HandHeldLegend/UniSNES/PCB/USB-C Wire Diagram External.png

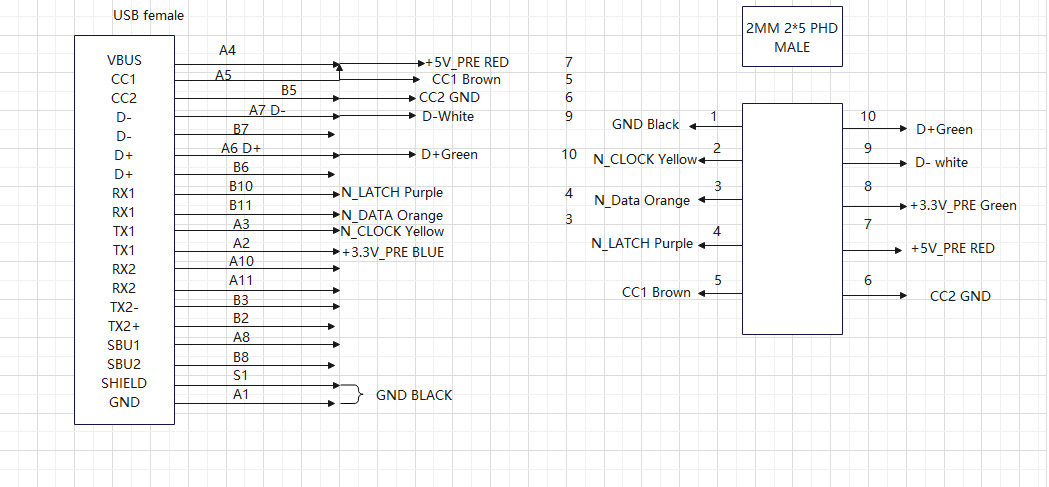
PCB/USB-C Wire Diagram External.png
