HandHeldLegend/UniSNES/PCB/UniSNES Board Export.dxf

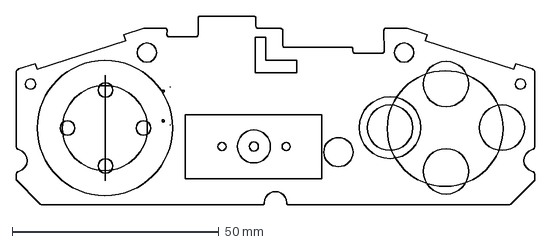
[picture p2: CAD file, 2023-09-26]
PCB/UniSNES Board Export.dxf
125.5 x 45.6 mm
