HandHeldLegend/UniSNES/FW/include/main.h

#include "hoja_includes.h"

#define PGPIO_BTN_A     0
#define PGPIO_BTN_B     1
#define PGPIO_BTN_X     2
#define PGPIO_BTN_Y     3

#define PGPIO_BTN_DUP       19
#define PGPIO_BTN_DDOWN     21
#define PGPIO_BTN_DLEFT     18
#define PGPIO_BTN_DRIGHT    20

#define PGPIO_BTN_SELECT    28
#define PGPIO_BTN_START     29
#define PGPIO_BTN_L         4
#define PGPIO_BTN_R         5

// Analog L Trigger ADC
//#define PADC_LT 1
// Analog R Trigger ADC
//#define PADC_RT 0

// Analog L Trigger GPIO
//#define PGPIO_LT 27
// Analog R Trigger GPIO
//#define PGPIO_RT 26

#define PGPIO_RUMBLE_MAIN   25
#define PGPIO_RUMBLE_BRAKE  24

// SPI ADC CLK pin
//#define PGPIO_SPI_CLK 2
// SPI ADC TX pin
//#define PGPIO_SPI_TX  3
// SPI ADC RX pin
//#define PGPIO_SPI_RX  0

// Left stick ADC Chip Select
//#define PGPIO_LS_CS   1
// Right stick ADC Chip Select
//#define PGPIO_RS_CS   4

//#define PGPIO_IMU0_CS 28
//#define PGPIO_IMU1_CS 29

  
