HandHeldLegend/UniSNES/(commit log)

2023-09-25 Commit library additions modules
    [UniSNES Board Export.dxf]
2023-09-26 First routing
    [UniSNES Board Export.dxf, UniSNES.kicad_pcb, UniSNES.kicad_sch]
2023-09-26 Add Trigger via option
    [UniSNES-B_Cu.gbr, UniSNES-B_Mask.gbr, UniSNES-B_Paste.gbr, UniSNES-B_Silkscreen.gbr, UniSNES-Edge_Cuts.gbr, UniSNES-F_Cu.gbr, UniSNES-F_Mask.gbr, UniSNES-F_Paste.gbr]
2023-09-26 Update Excel BOM
    [UniSNES BOM.xlsx]
2023-11-02 Update backend
    [UniSNES.kicad_pcb, UniSNES.kicad_sch]
